db-electronics/gen-sms-powerpcb-kicad/README.md

# Genesis and SMS power PCB
A simple PCB which provides +5V via a micro-usb phone charger to Genesis and SMS cartridges.
