db-electronics/gen-sms-powerpcb-kicad/(commit log)

2018-11-16 initial project commit
    [power-pcb.kicad_pcb, power-pcb.sch]
2018-11-17 changed USB conn
    [power-pcb.kicad_pcb, power-pcb.sch]
2018-11-18 re-routed with SMT usb connector
    [power-pcb.kicad_pcb]
2018-11-21 added C101, C102 part numbers, added BOM and Gerbers for 0.1 release
    [power-pcb.kicad_pcb, power-pcb.sch]
2018-11-21 would be nice to add -A files before a release
    [power-pcb_0.1.csv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]
2022-11-03 new 6.0 format
    [power-pcb.kicad_pcb, power-pcb.kicad_sch]
2022-11-07 added a standard B connector for easier soldering
    [power-pcb-B.Cu.gbl, power-pcb-B.Mask.gbs, power-pcb-B_Cu.gbl, power-pcb-B_Mask.gbs, power-pcb-B_Silkscreen.gbo, power-pcb-Edge.Cuts.gm1, power-pcb-Edge_Cuts.gm1, power-pcb-F.Cu.gtl]
