db-electronics/gen-sms-powerpcb-kicad/(notices)

Notices in the files:
power-pcb/power-pcb.kicad_pcb:
Licensed under CERN OHL v.1.2
Copyright René Richard 2022
power-pcb/power-pcb.sch:
Copyright René Richard 2018
